kuraiheka/BachelorProject/Figures and images/Servo Test/Servo Test 4.png

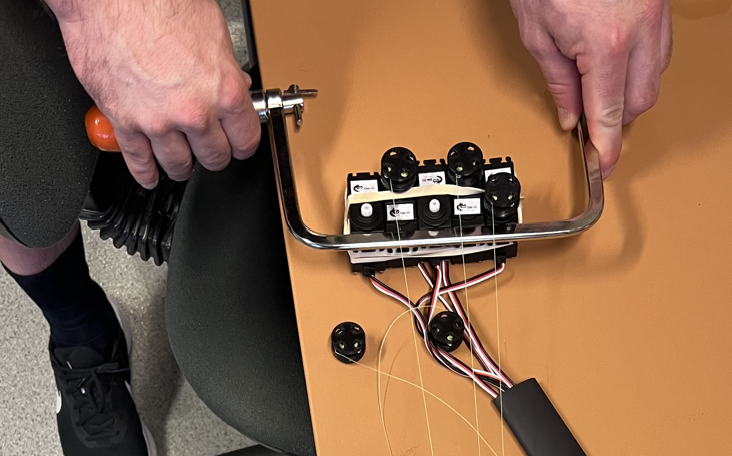
Figures and images/Servo Test/Servo Test 4.png
