kuraiheka/BachelorProject/Figures and images/primary glove.jpg

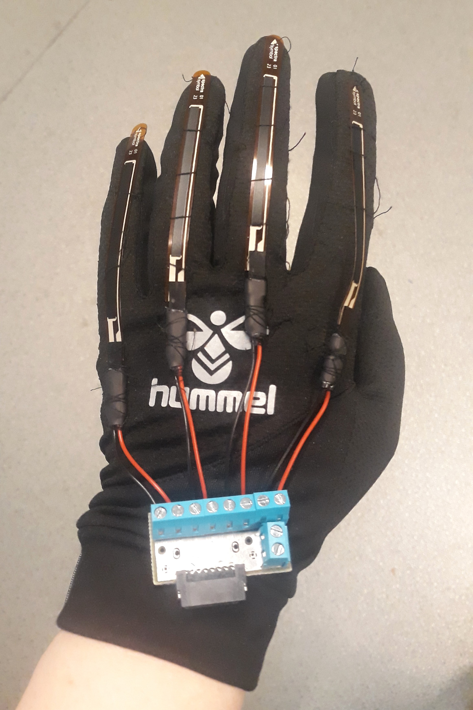
Figures and images/primary glove.jpg
