kuraiheka/BachelorProject/README.md

Code for our bachelor project. Not intended for public consumption.
