kuraiheka/BachelorProject/Figures and images/Circuit diagram.jpg

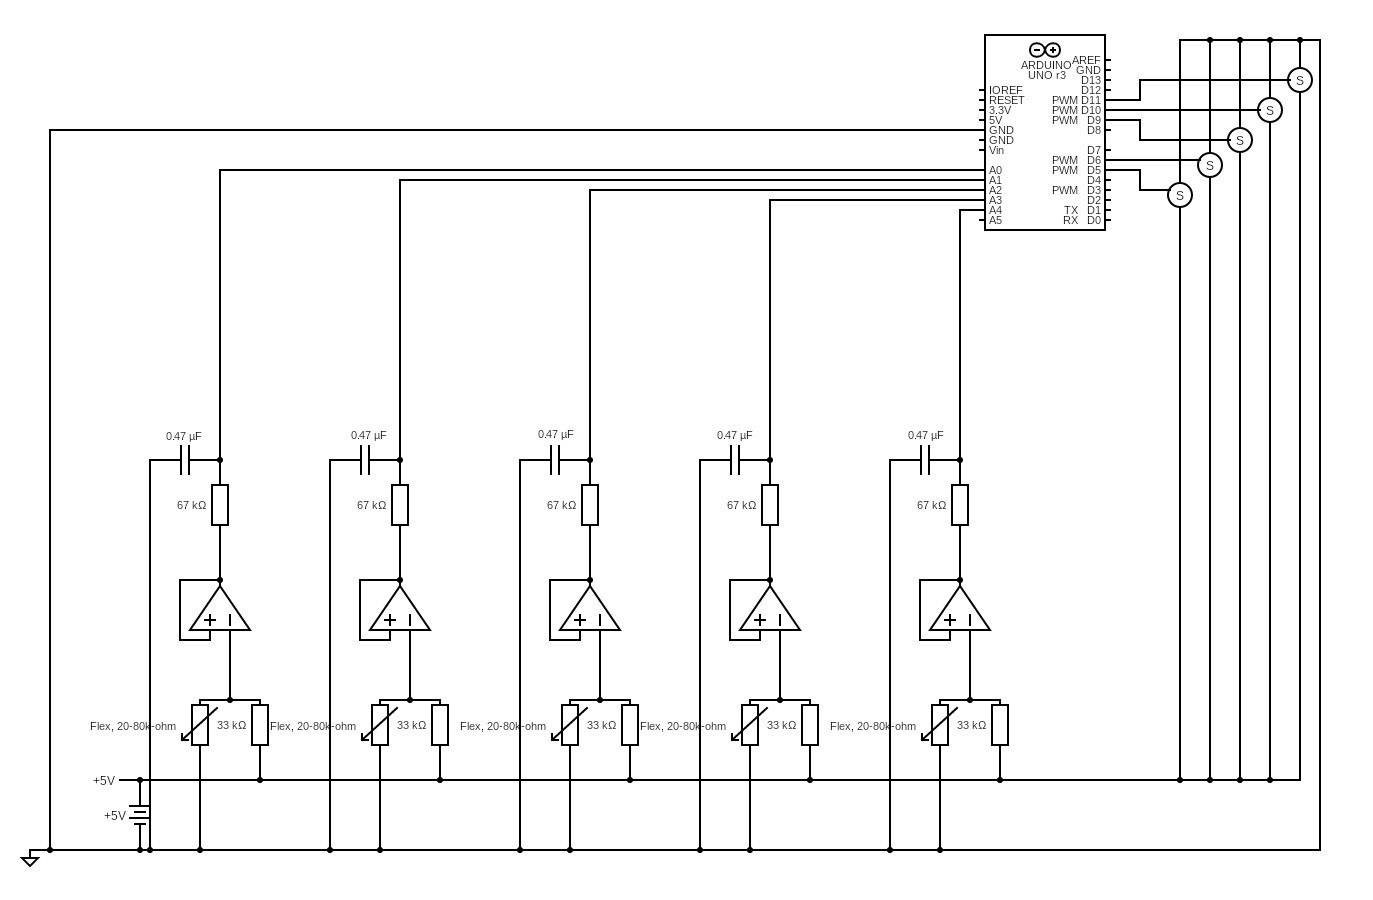
Figures and images/Circuit diagram.jpg
