kuraiheka/BachelorProject/Figures and images/Flowchart.png

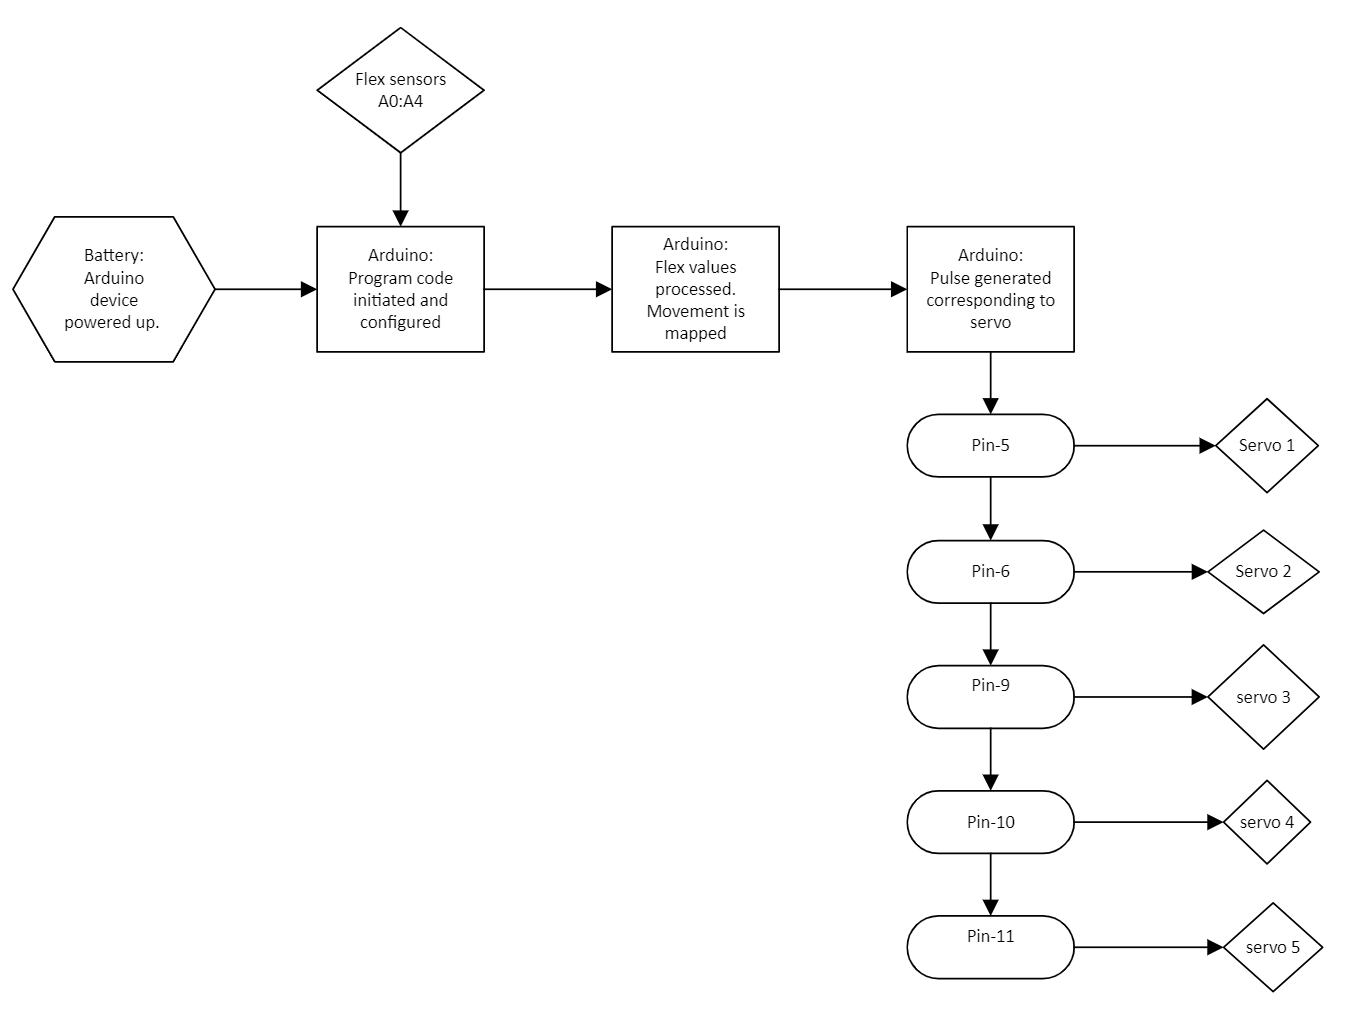
Figures and images/Flowchart.png
