kuraiheka/BachelorProject/Figures and images/secondary glove 1.jpg

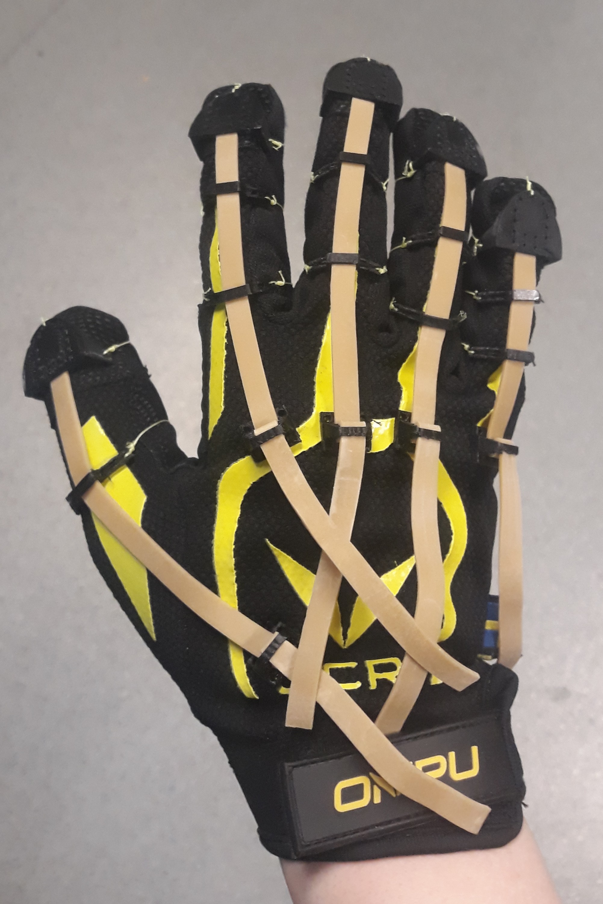
Figures and images/secondary glove 1.jpg
