kuraiheka/BachelorProject/Figures and images/secondary glove 2.jpg

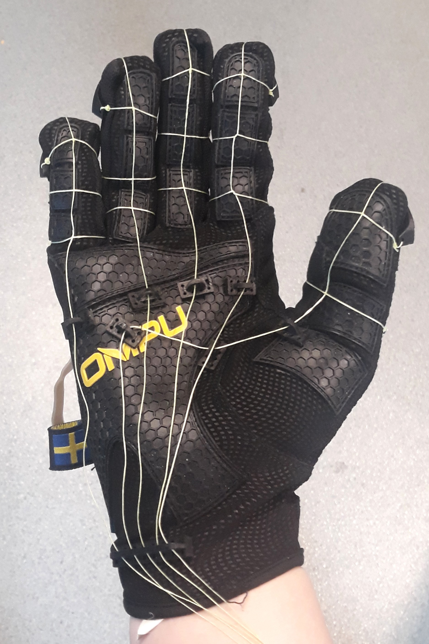
Figures and images/secondary glove 2.jpg
