kuraiheka/BachelorProject/3D print CAD files/Pulley.stl

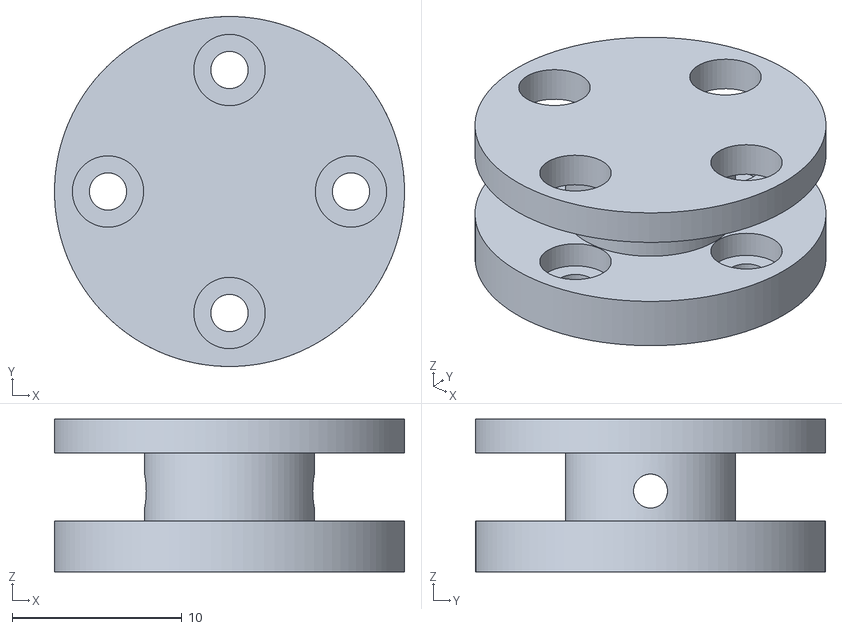
[picture p7: CAD file, 2024-05-26]
3D print CAD files/Pulley.stl
20.6 x 20.6 x 9.00
