kuraiheka/BachelorProject/PCB Files/Bachelor Shield/3DModels/1x6.STEP

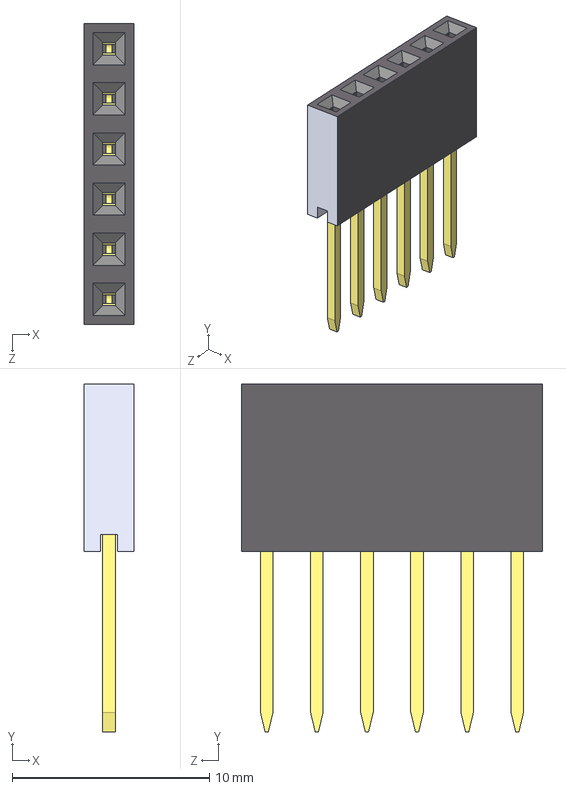
[picture p8: CAD file, 2024-05-26]
PCB Files/Bachelor Shield/3DModels/1x6.STEP
2.54 x 17.6 x 15.2 mm
