kuraiheka/BachelorProject/3D print CAD files/Tendon Guide.stl

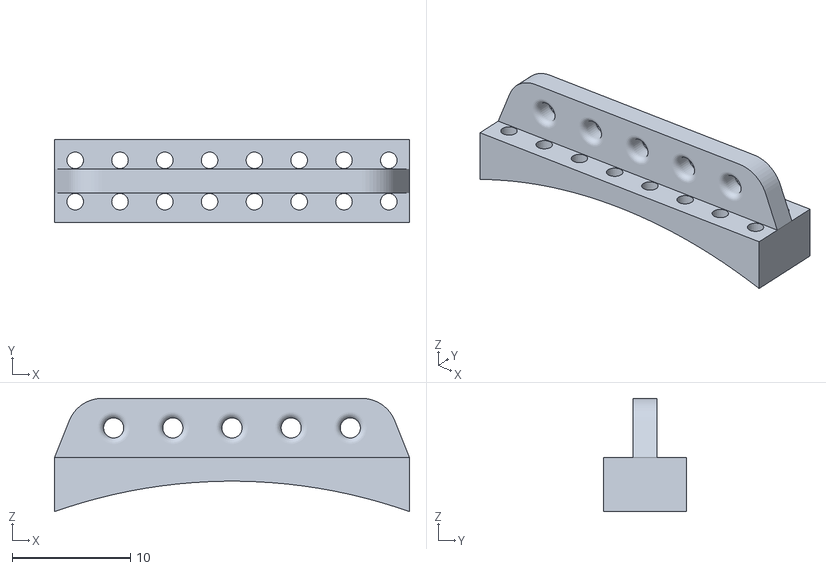
[picture p9: CAD file, 2024-05-26]
3D print CAD files/Tendon Guide.stl
30.0 x 7.00 x 9.57
