kuraiheka/BachelorProject/PCB Files/Bachelor Shield/3DModels/1x4.STEP

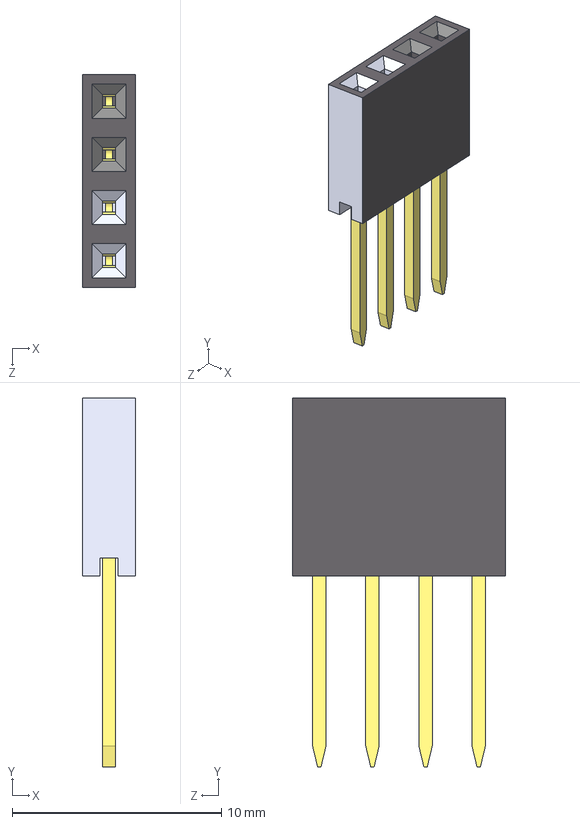
[picture p10: CAD file, 2024-05-26]
PCB Files/Bachelor Shield/3DModels/1x4.STEP
2.54 x 17.6 x 10.2 mm
