kuraiheka/BachelorProject/3D print CAD files/Band Buckle.stl

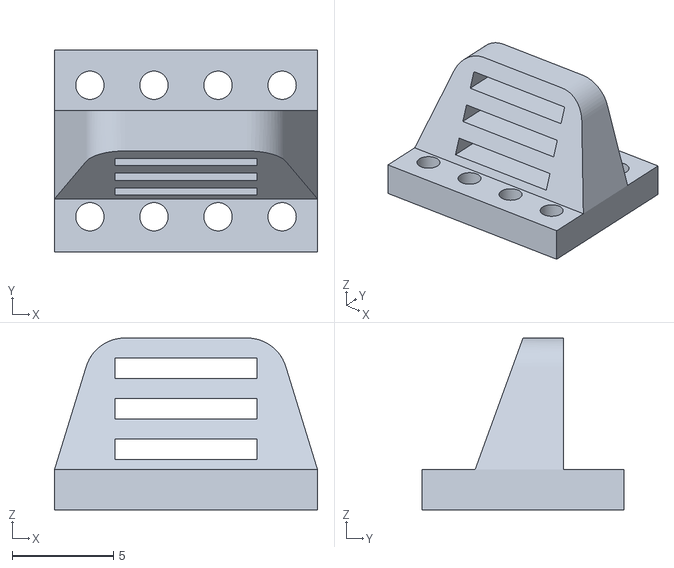
[picture p11: CAD file, 2024-05-26]
3D print CAD files/Band Buckle.stl
13.0 x 10.0 x 8.50
