kuraiheka/BachelorProject/PCB Files/Bachelor Shield/3DModels/1x2.STEP

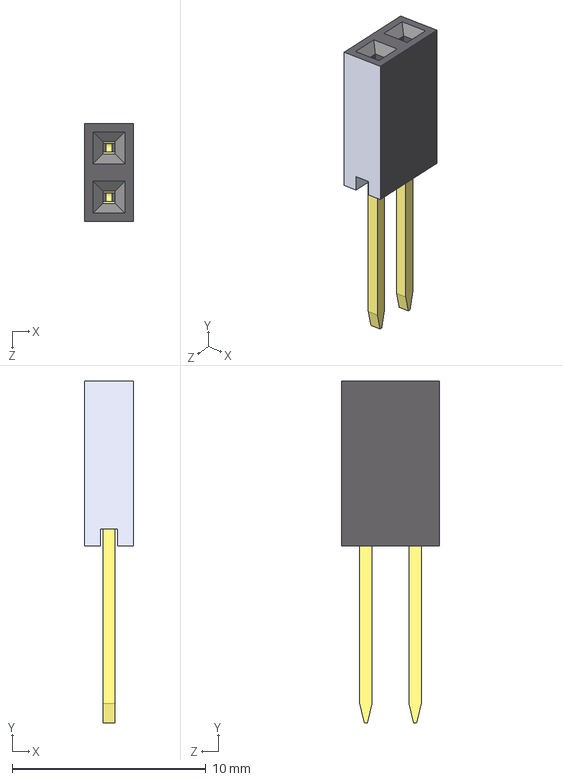
[picture p12: CAD file, 2024-05-26]
PCB Files/Bachelor Shield/3DModels/1x2.STEP
2.54 x 17.6 x 5.08 mm
