kuraiheka/BachelorProject/3D print CAD files/Tendon Guide Single.stl

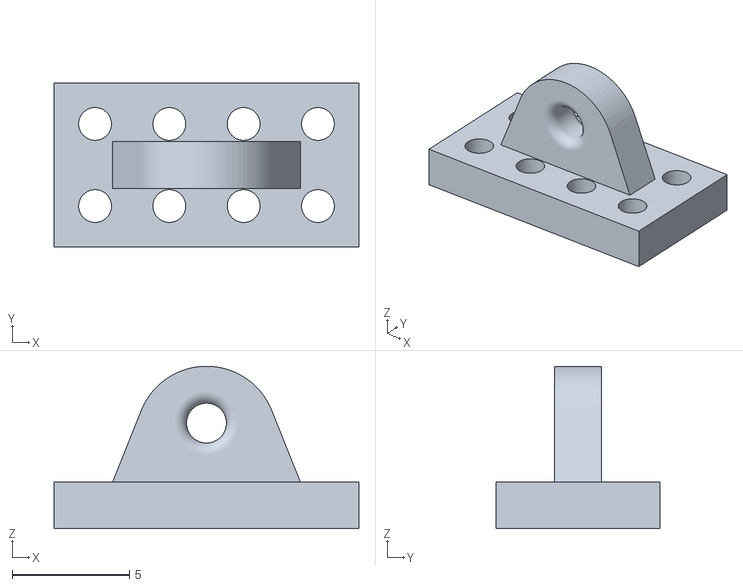
[picture p13: CAD file, 2024-05-26]
3D print CAD files/Tendon Guide Single.stl
13.0 x 7.00 x 6.92
