kuraiheka/BachelorProject/PCB Files/Bachelor Shield/3DModels/1x7.STEP

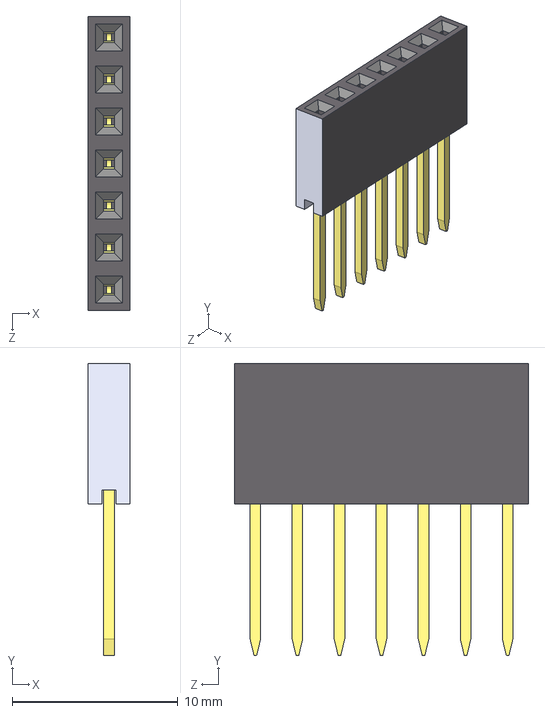
[picture p14: CAD file, 2024-05-26]
PCB Files/Bachelor Shield/3DModels/1x7.STEP
2.54 x 17.6 x 17.8 mm
