kuraiheka/BachelorProject/PCB Files/Bachelor Shield/3DModels/1x9.STEP

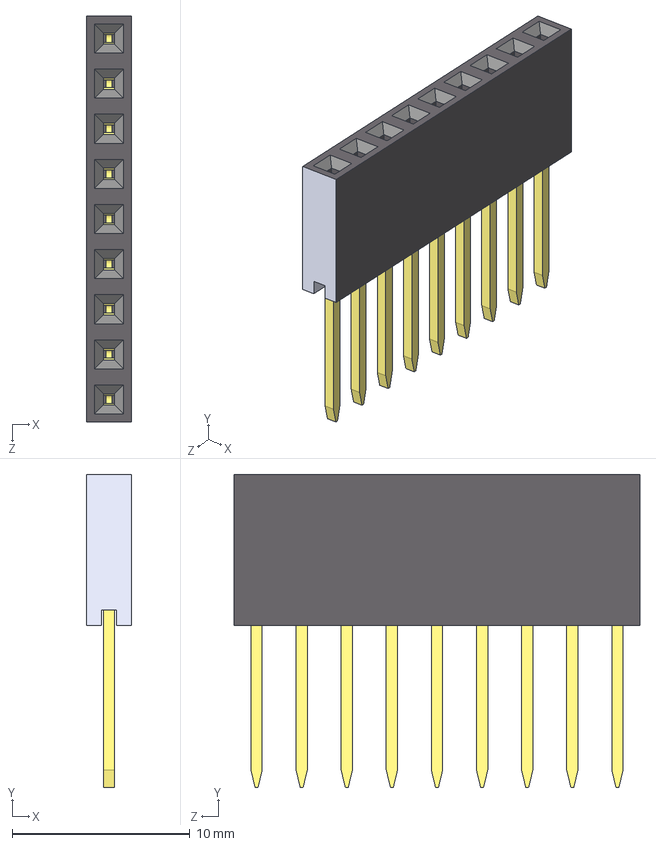
[picture p15: CAD file, 2024-05-26]
PCB Files/Bachelor Shield/3DModels/1x9.STEP
2.54 x 17.6 x 22.9 mm
