kuraiheka/BachelorProject/PCB Files/Bachelor Shield/3DModels/1x5.STEP

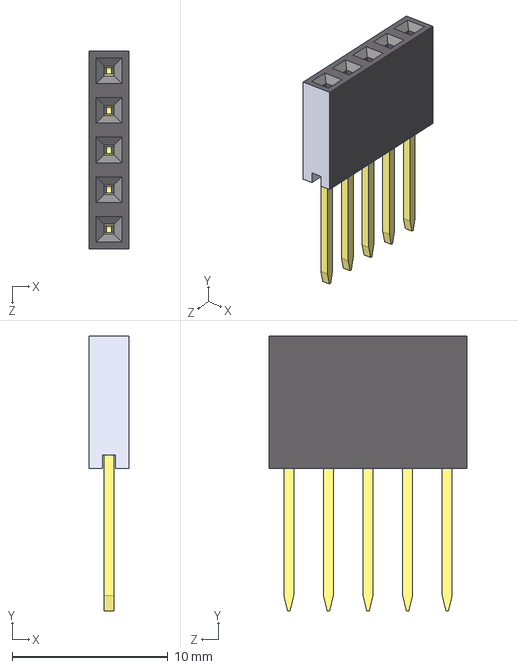
[picture p16: CAD file, 2024-05-26]
PCB Files/Bachelor Shield/3DModels/1x5.STEP
2.54 x 17.6 x 12.7 mm
