kuraiheka/BachelorProject/PCB Files/Bachelor Shield/3DModels/pin header female 2.54mm_0.1in.STEP

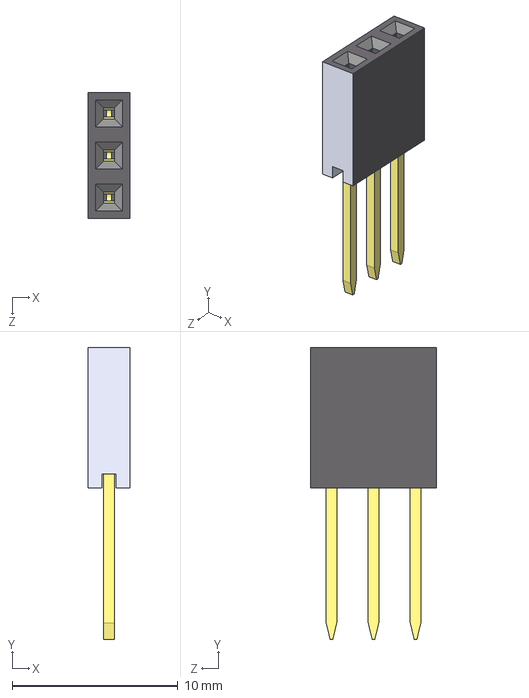
[picture p17: CAD file, 2024-05-26]
PCB Files/Bachelor Shield/3DModels/pin header female 2.54mm_0.1in.STEP
2.54 x 17.6 x 7.62 mm
