kuraiheka/BachelorProject/PCB Files/Bachelor Shield/3DModels/1x10.STEP

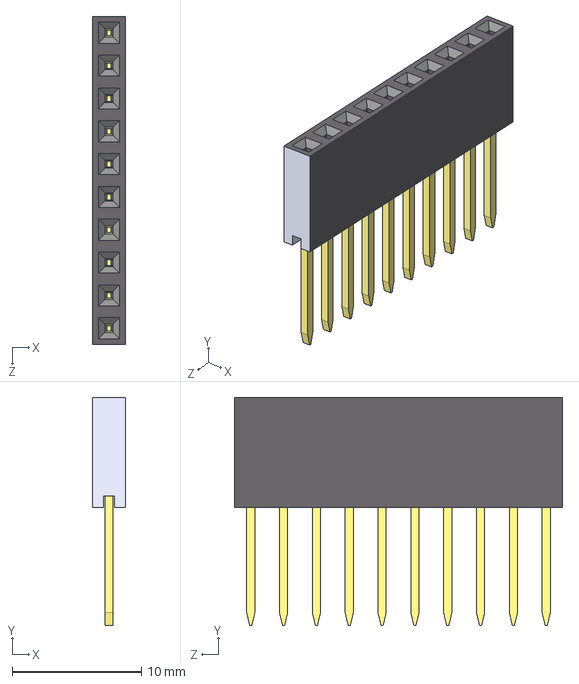
[picture p18: CAD file, 2024-05-26]
PCB Files/Bachelor Shield/3DModels/1x10.STEP
2.54 x 17.6 x 25.4 mm
