kuraiheka/BachelorProject/(list of files, cad)

Other CAD files:
3D print CAD files/Band Buckle.f3d
3D print CAD files/Pulley.f3d
3D print CAD files/Tendon Guide Single.f3d
3D print CAD files/Tendon Guide.f3d
PCB Files/Bachelor Shield/3DModels/pin_header_female_2.54mm_0.1in.STEP
