kuraiheka/BachelorProject/Figures and images/glove assembley placement.png

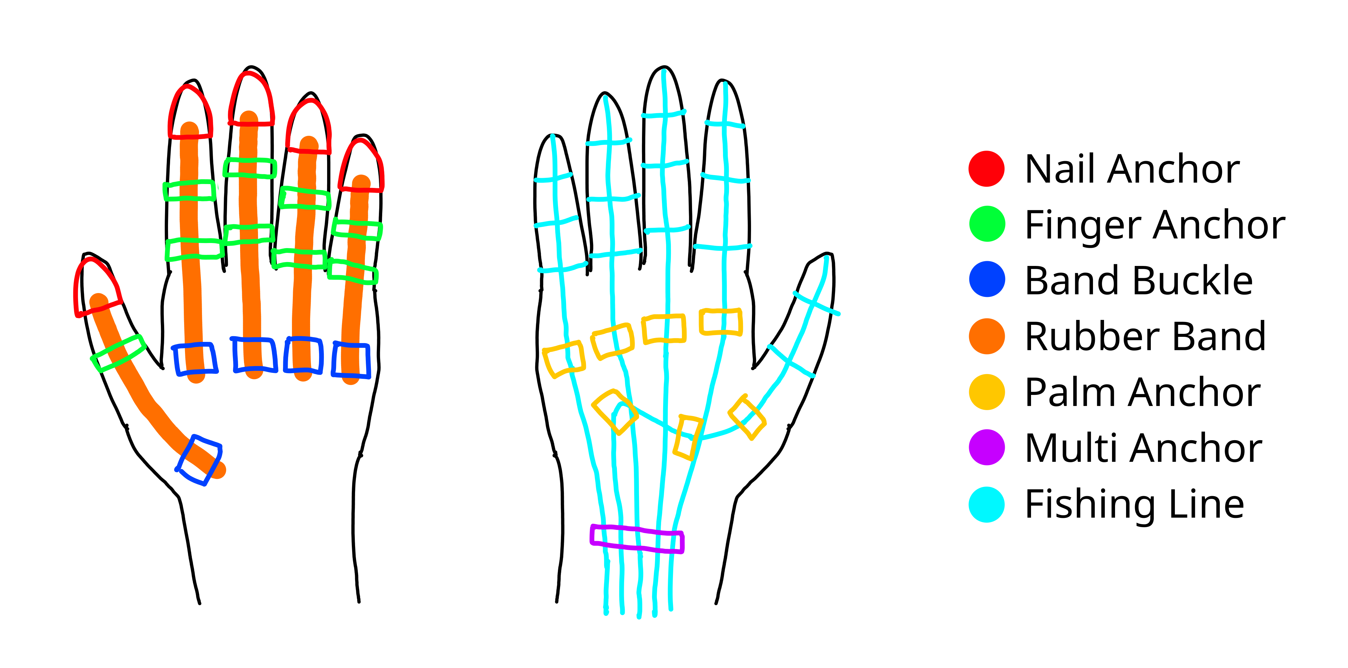
Figures and images/glove assembley placement.png
