kuraiheka/BachelorProject/Figures and images/Servo Test/pulley_prob_3.png

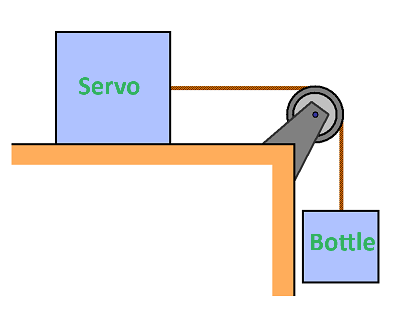
Figures and images/Servo Test/pulley_prob_3.png
