kuraiheka/BachelorProject/Figures and images/Bachelor Shield.pdf

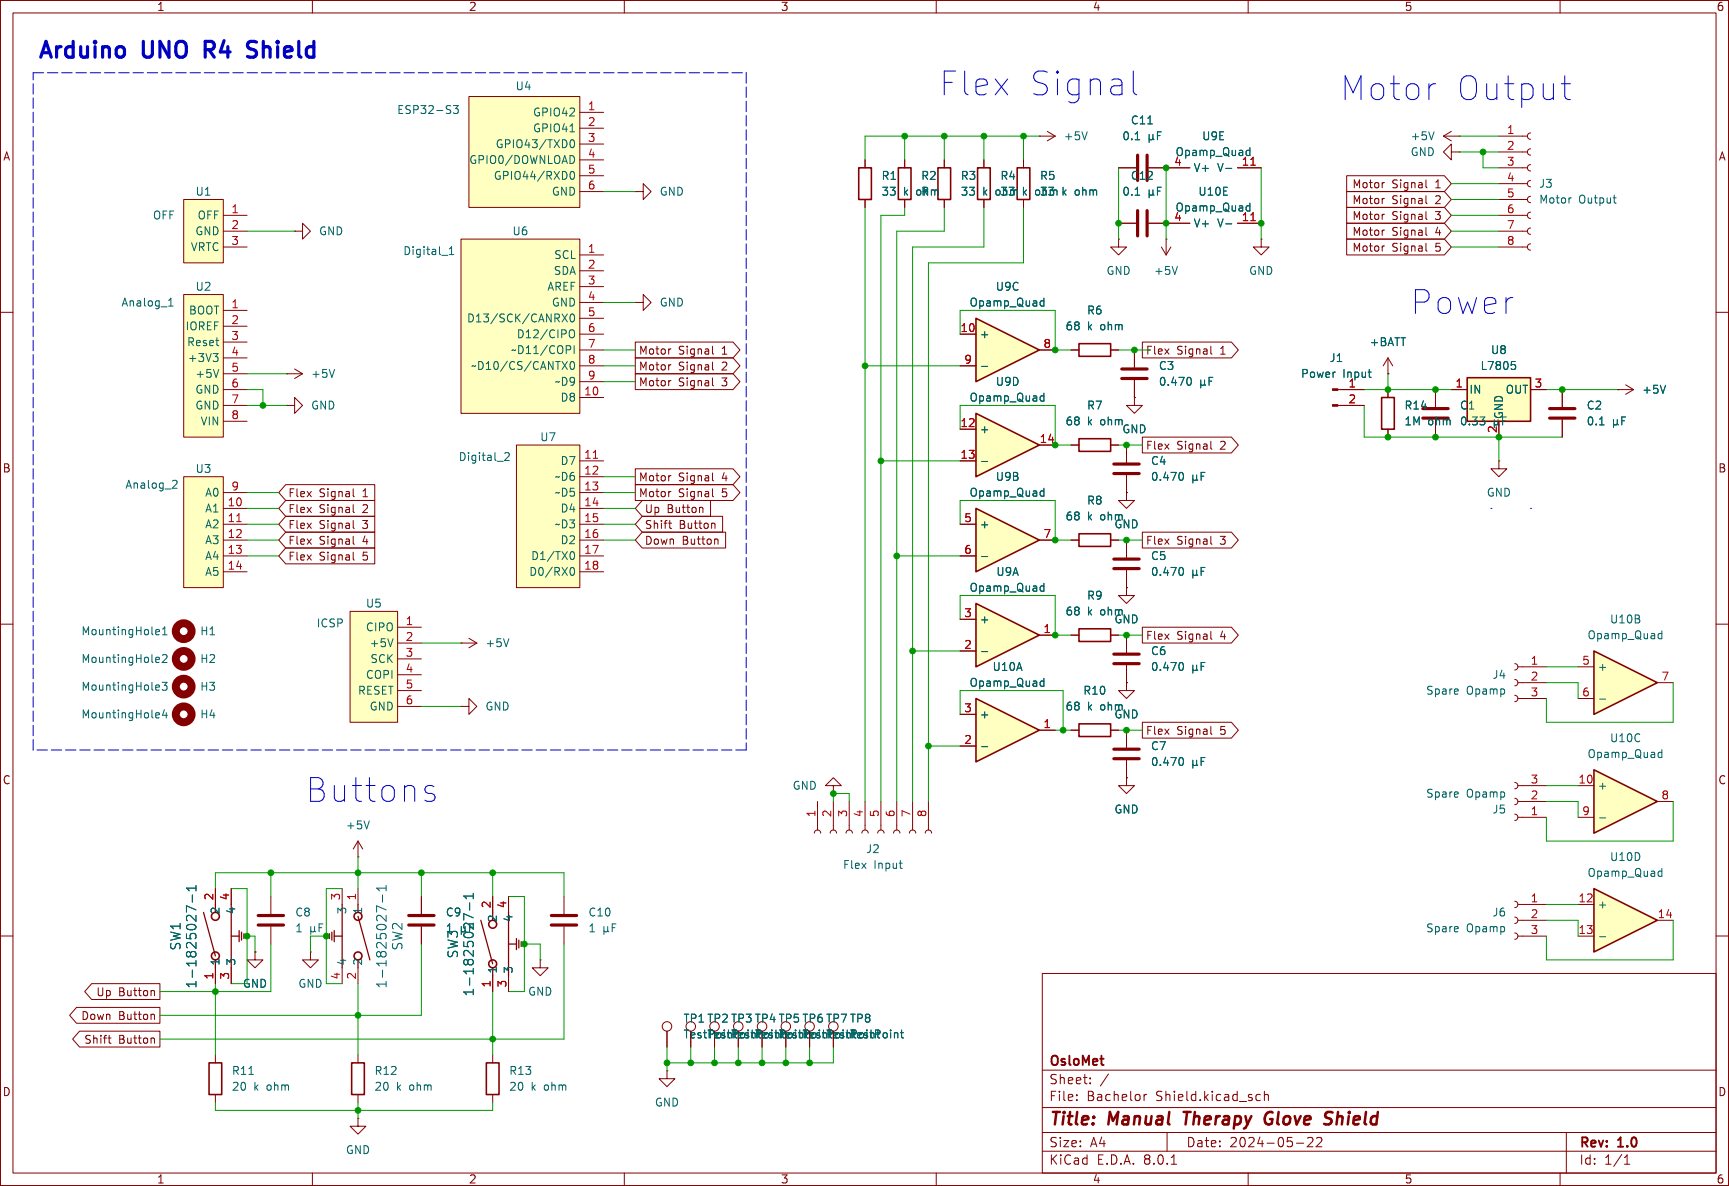
[picture p21: page 1]
