kuraiheka/BachelorProject/PCB Files/Bachelor Shield/Bachelor Shield.kicad_pcb

## KiCad design PCB Files/Bachelor Shield/Bachelor Shield.kicad_pcb (2024-05-26)

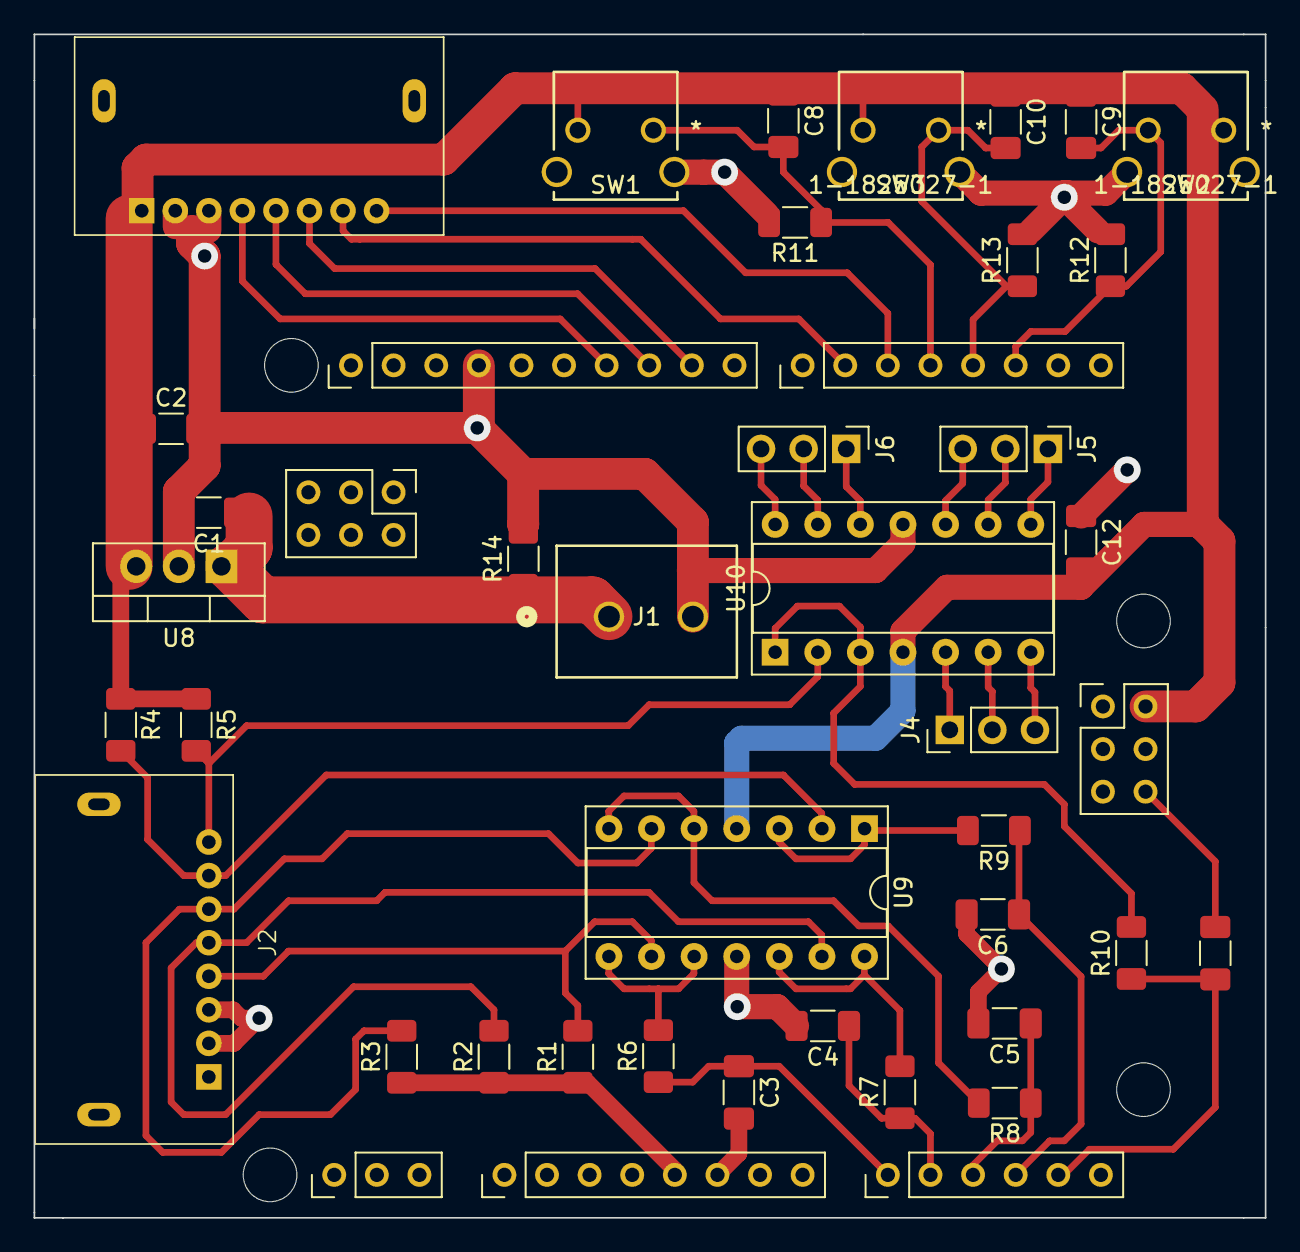
[picture p22: board Bachelor Shield.kicad_pcb from above]

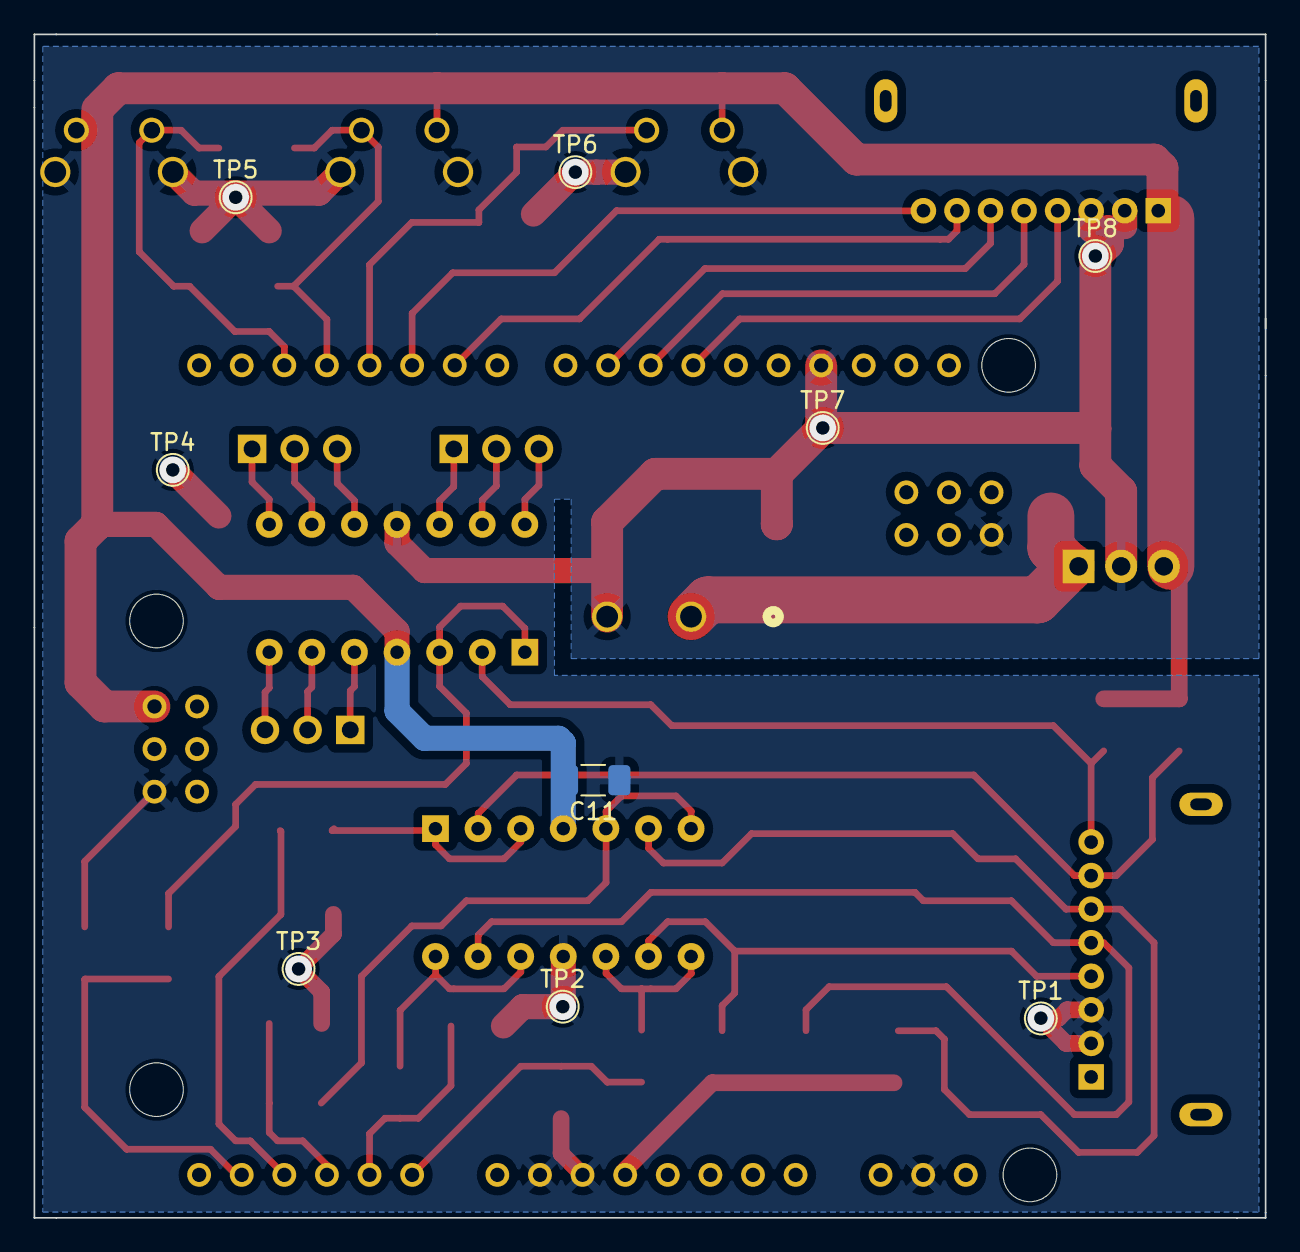
[picture p23: board Bachelor Shield.kicad_pcb from below]

Board: 2 copper layers, 73.4 x 70.6 mm, 57 parts (9 on the bottom side), 35 nets.

Parts:
C1, C2, C3, C4, C5, C6, C7, C8, C9, C10, C11, C12: C; C_1206_3216Metric_Pad1.33x1.80mm_HandSolder
H1: MountingHole1; Arduino_MountingHole
H2: MountingHole2; Arduino_MountingHole
H3: MountingHole3; Arduino_MountingHole
H4: MountingHole4; Arduino_MountingHole
J1: Power Input; CONN_TB002-500-02BE_CUD
J2: Flex Input; Molex_2200301081
J3: Motor Output; Molex_2200301081
J4, J5, J6: Spare Opamp; PinHeader_1x03_P2.54mm_Vertical
R1, R2, R3, R4, R5, R6, R7, R8, R9, R10, R11, R12, R13, R14: R; R_1206_3216Metric_Pad1.30x1.75mm_HandSolder
SW1, SW2, SW3: 1-1825027-1
TP1, TP2, TP3, TP4, TP5, TP6, TP7, TP8: TestPoint; TestPoint_Pad_D1.5mm
U1: OFF; Arduino_PinSocket_1x03_P2.54mm_Vertical
U2: Analog_1; Arduino_PinSocket_1x08_P2.54mm_Vertical
U3: Analog_2; Arduino_PinSocket_1x06_P2.54mm_Vertical
U4: ESP32-S3; Arduino_PinSocket_2x03_P2.54mm_Vertical
U5: ICSP; Arduino_PinSocket_2x03_P2.54mm_Vertical
U6: Digital_1; Arduino_PinSocket_1x10_P2.54mm_Vertical
U7: Digital_2; Arduino_PinSocket_1x08_P2.54mm_Vertical
U8: L7805; TO-220-3_Vertical
U9, U10: Opamp_Quad; DIP-14_W7.62mm_Socket

Connections:
+5V: C2.1, C8.1, C9.1, C10.1, C11.2, C12.2, J3.1, R1.1, R2.1, R3.1, R4.1, R5.1, SW1.2, SW2.1, SW3.2, U2.5 (+5V), U5.2 (+5V), U8.3 (OUT), U9.4 (V+), U10.4 (V+)
+BATT: C1.1, J1.1, R14.1, U8.1 (IN)
Down Button: C9.2, R12.1, SW2.2, U7.16 (D2)
Flex Signal 1: C3.1, R6.1, U3.9 (A0)
Flex Signal 2: C4.1, R7.1, U3.10 (A1)
Flex Signal 3: C5.1, R8.1, U3.11 (A2)
Flex Signal 4: C6.1, R9.1, U3.12 (A3)
Flex Signal 5: C7.1, R10.1, U3.13 (A4)
GND: C1.2, C2.2, C3.2, C4.2, C5.2, C6.2, C7.2, C11.1, C12.1, J1.2, J2.2, J2.3, J3.2, J3.3, R11.2, R12.2, R13.2, R14.2, SW1.3, SW1.4, SW2.3, SW2.4, SW3.3, SW3.4, TP1.1, TP2.1, TP3.1, TP4.1, TP5.1, TP6.1, TP7.1, TP8.1, U1.2 (GND), U2.6 (GND), U2.7 (GND), U4.6 (GND), U5.6 (GND), U6.4 (GND), U8.2 (GND), U9.11 (V-), U10.11 (V-)
Motor Signal 1: J3.4, U6.7 (~D11/COPI)
Motor Signal 2: J3.5, U6.8 (~D10/CS/CANTX0)
Motor Signal 3: J3.6, U6.9 (~D9)
Motor Signal 4: J3.7, U7.12 (~D6)
Motor Signal 5: J3.8, U7.13 (~D5)
unnamed: J2.4, R1.2, U9.9 (-)
unnamed: J2.5, R2.2, U9.13 (-)
unnamed: J2.6, R3.2, U9.6 (-)
unnamed: J2.7, R4.2, U9.2 (-)
unnamed: J2.8, R5.2, U10.2 (-)
unnamed: J4.1, U10.5 (+)
unnamed: J4.2, U10.6 (-)
unnamed: J4.3, U10.7
unnamed: J5.1, U10.8
unnamed: J5.2, U10.9 (-)
unnamed: J5.3, U10.10 (+)
unnamed: J6.1, U10.12 (+)
unnamed: J6.2, U10.13 (-)
unnamed: J6.3, U10.14
unnamed: R9.2, U9.1, U9.3 (+)
unnamed: R8.2, U9.5 (+), U9.7
unnamed: R6.2, U9.8, U9.10 (+)
unnamed: R7.2, U9.12 (+), U9.14
unnamed: R10.2, U10.1, U10.3 (+)
Shift Button: C10.2, R13.1, SW3.1, U7.15 (~D3)
Up Button: C8.2, R11.1, SW1.1, U7.14 (D4)
