kuraiheka/BachelorProject/PCB Files/Sensor Board v2/Sensor Board v2.kicad_pcb

## KiCad design PCB Files/Sensor Board v2/Sensor Board v2.kicad_pcb (2024-05-26)

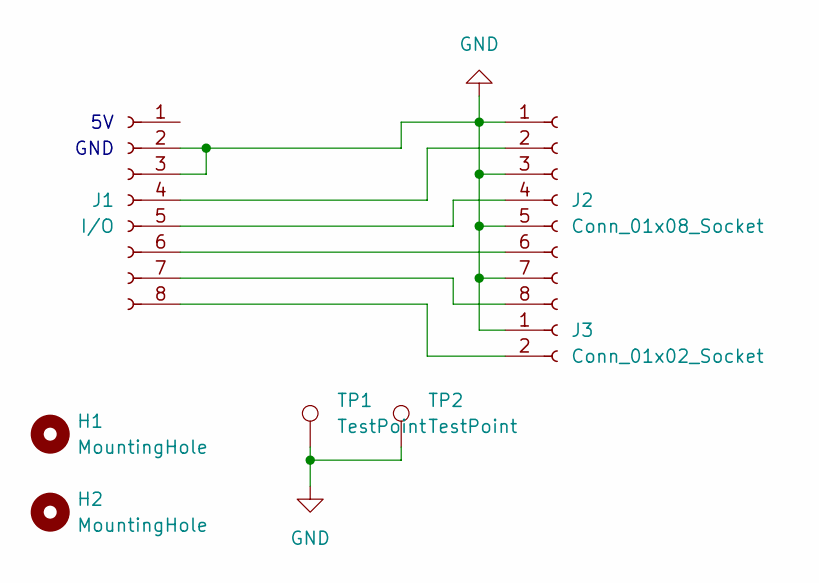
[picture p24: schematic Sensor Board v2.kicad_sch]

Parts:
H1, H2: MountingHole; MountingHole_2.2mm_M2
J1: I/O; Molex_2200301081
J2: Conn_01x08_Socket; CUI_TB006-508-08BE
J3: Conn_01x02_Socket; CONN_TB006-508-02_CUD
TP1, TP2: TestPoint; TestPoint_Pad_D1.5mm

Connections:
GND: J1.2, J1.3, J2.1, J2.3, J2.5, J2.7, J3.1, TP1.1, TP2.1
unnamed: J1.4, J2.2
unnamed: J1.5, J2.4
unnamed: J1.6, J2.6
unnamed: J1.7, J2.8
unnamed: J1.8, J3.2

Notes on the sheet:
GND

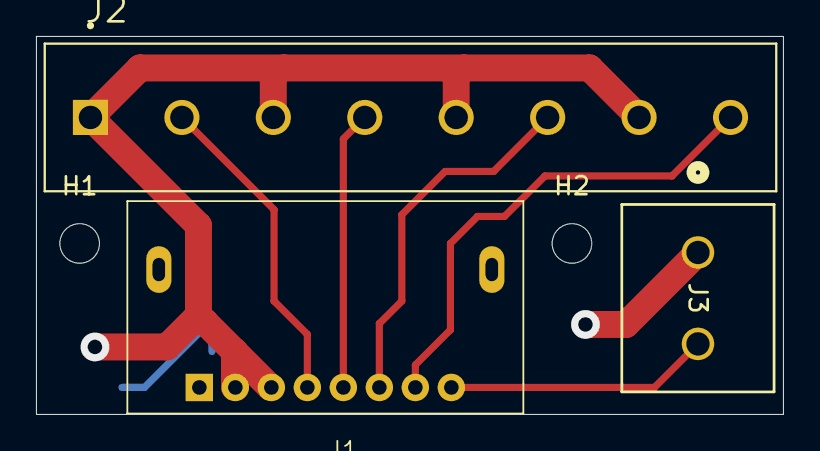
[picture p25: board Sensor Board v2.kicad_pcb from above]

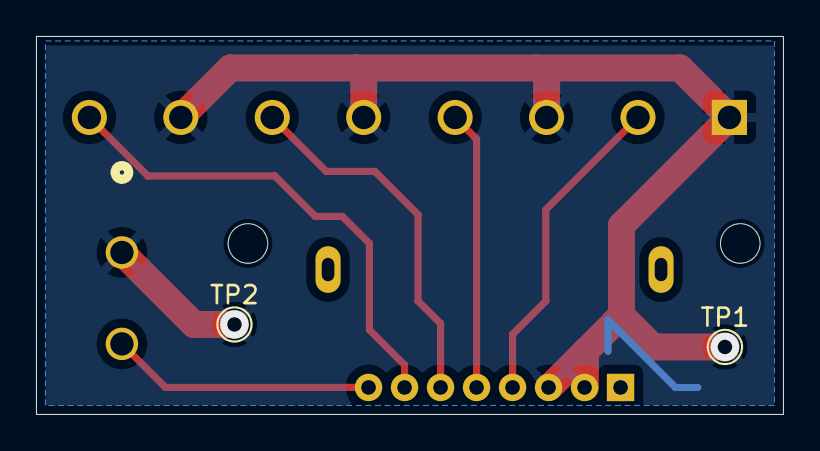
[picture p26: board Sensor Board v2.kicad_pcb from below]

Board: 2 copper layers, 41.5 x 21.0 mm, 7 parts (2 on the bottom side), 6 nets.
