kuraiheka/BachelorProject/PCB Files/Motor Board/Motor Board.kicad_pcb

## KiCad design PCB Files/Motor Board/Motor Board.kicad_pcb (2024-05-26)

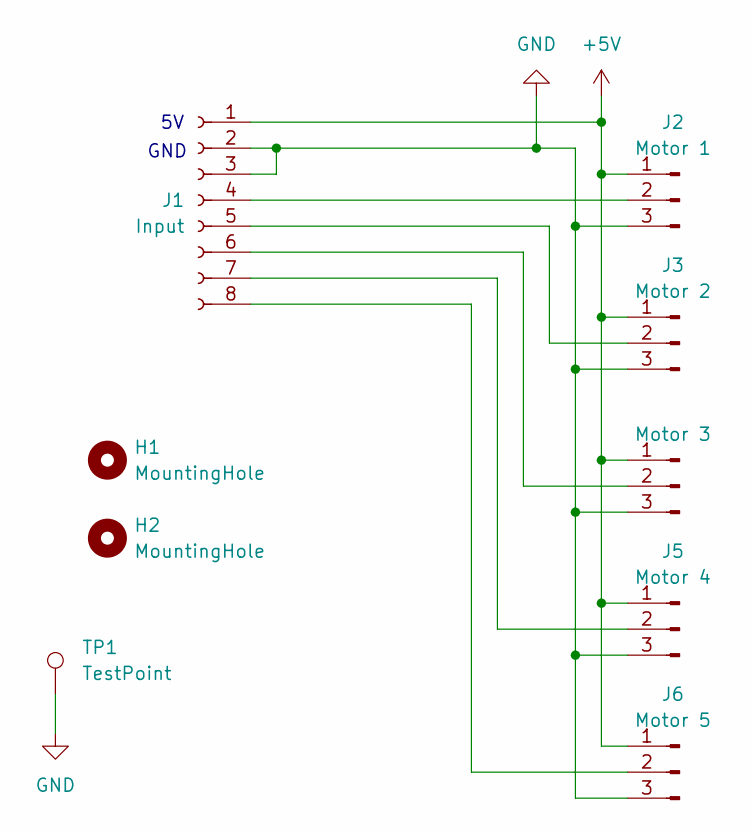
[picture p27: schematic Motor Board.kicad_sch]

Parts:
H1, H2: MountingHole; MountingHole_2.2mm_M2
J1: Input; Molex_2200291085
J2: Motor 1; PinHeader_1x03_P2.54mm_Horizontal
J3: Motor 2; PinHeader_1x03_P2.54mm_Horizontal
J4: Motor 3; PinHeader_1x03_P2.54mm_Horizontal
J5: Motor 4; PinHeader_1x03_P2.54mm_Horizontal
J6: Motor 5; PinHeader_1x03_P2.54mm_Horizontal
TP1: TestPoint; TestPoint_Pad_D1.5mm

Connections:
+5V: J1.1, J2.1, J3.1, J4.1, J5.1, J6.1
GND: J1.2, J1.3, J2.3, J3.3, J4.3, J5.3, J6.3, TP1.1
unnamed: J1.4, J2.2
unnamed: J1.5, J3.2
unnamed: J1.6, J4.2
unnamed: J1.7, J5.2
unnamed: J1.8, J6.2

Notes on the sheet:
GND

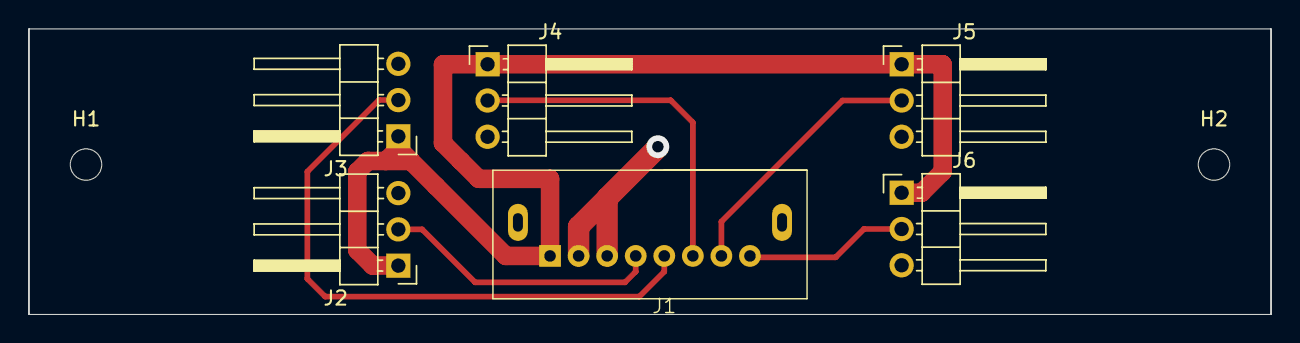
[picture p28: board Motor Board.kicad_pcb from above]

Board: 2 copper layers, 87.0 x 20.0 mm, 9 parts (1 on the bottom side), 7 nets.
