kuraiheka/BachelorProject/(commit log)

2024-04-22 Revert "Add files via upload"
    This reverts commit ca217c87d8a2c0d947ec75824c5118caad07457c.
    [servo_vidar_direct_drive_filtered_adjusted.ino]
2024-04-24 Added servo adjustment functionality
2024-05-26 Everything included
    [1x10.STEP, 1x2.STEP, 1x4.STEP, 1x5.STEP, 1x6.STEP, 1x7.STEP, 1x9.STEP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]
